reufer/gigafoc/hardware/P1B/gigafoc.pdf

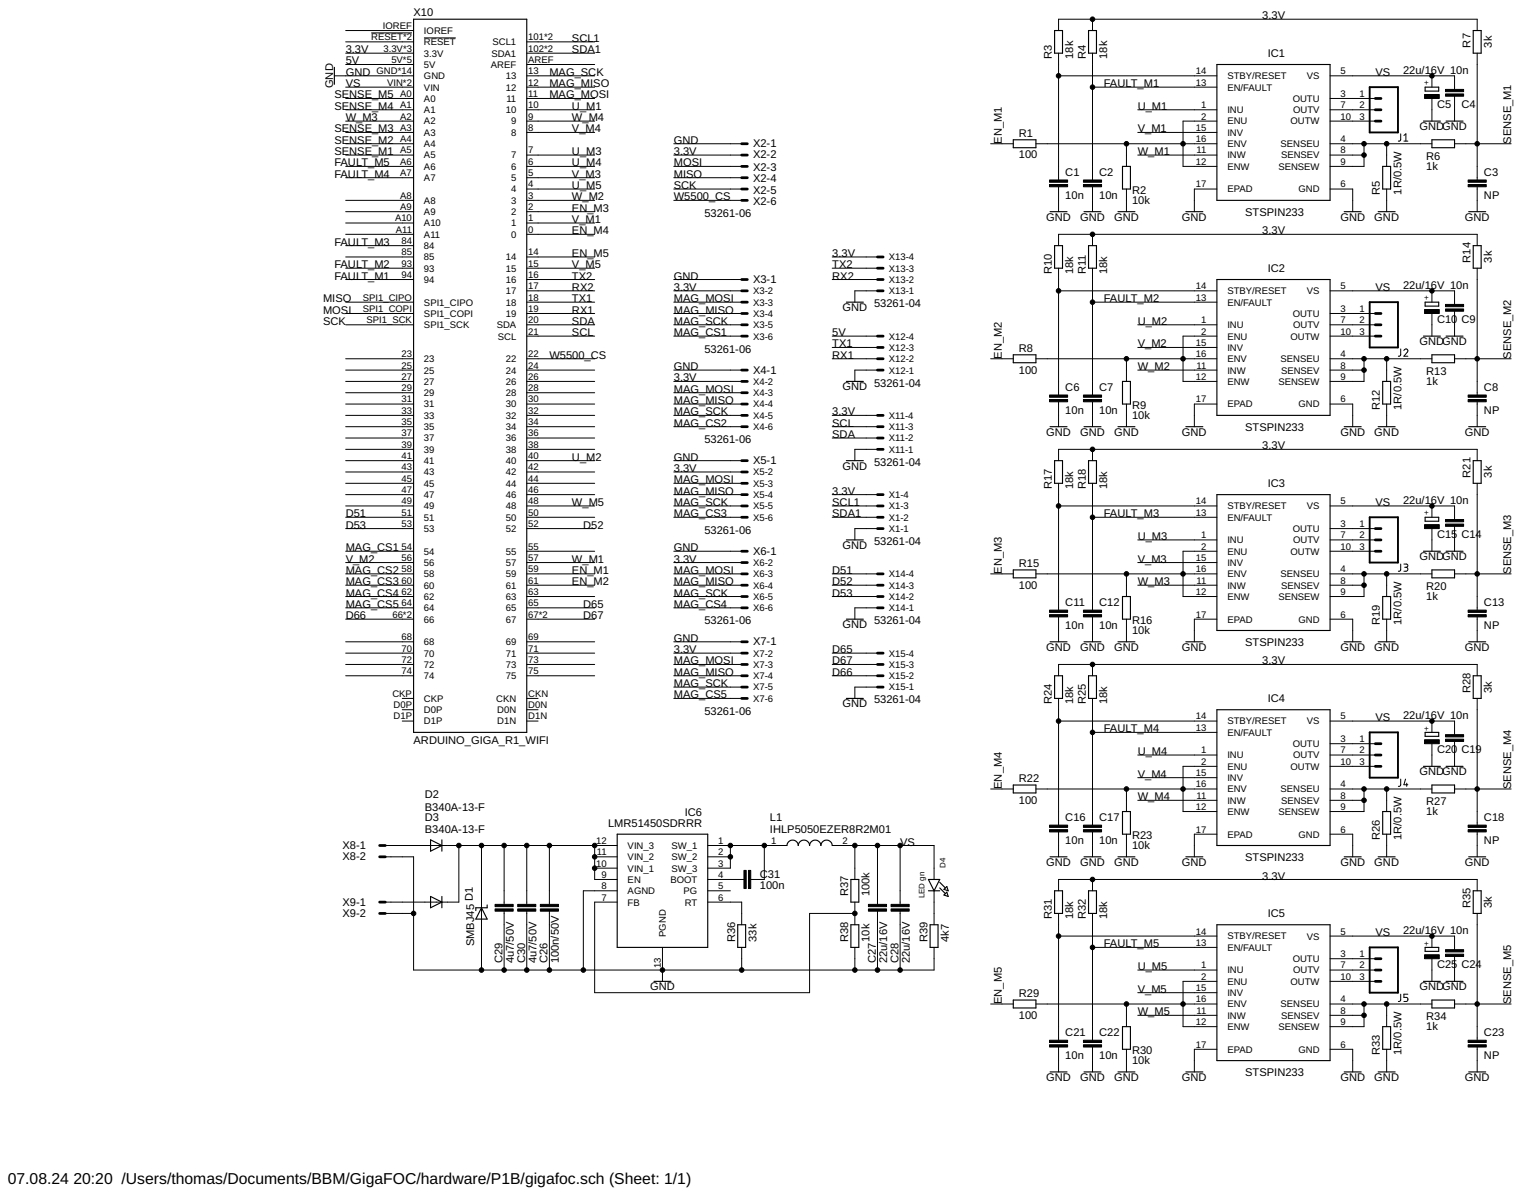
[picture p1: page 1]

18k 10n GND GND GND GND

07.08.24 20:20 /Users/thomas/Documents/BBM/GigaFOC/hardware/P1B/gigafoc.sch (Sheet: 1/1)
