reufer/gigafoc/hardware/P1A/gigafoc.pdf

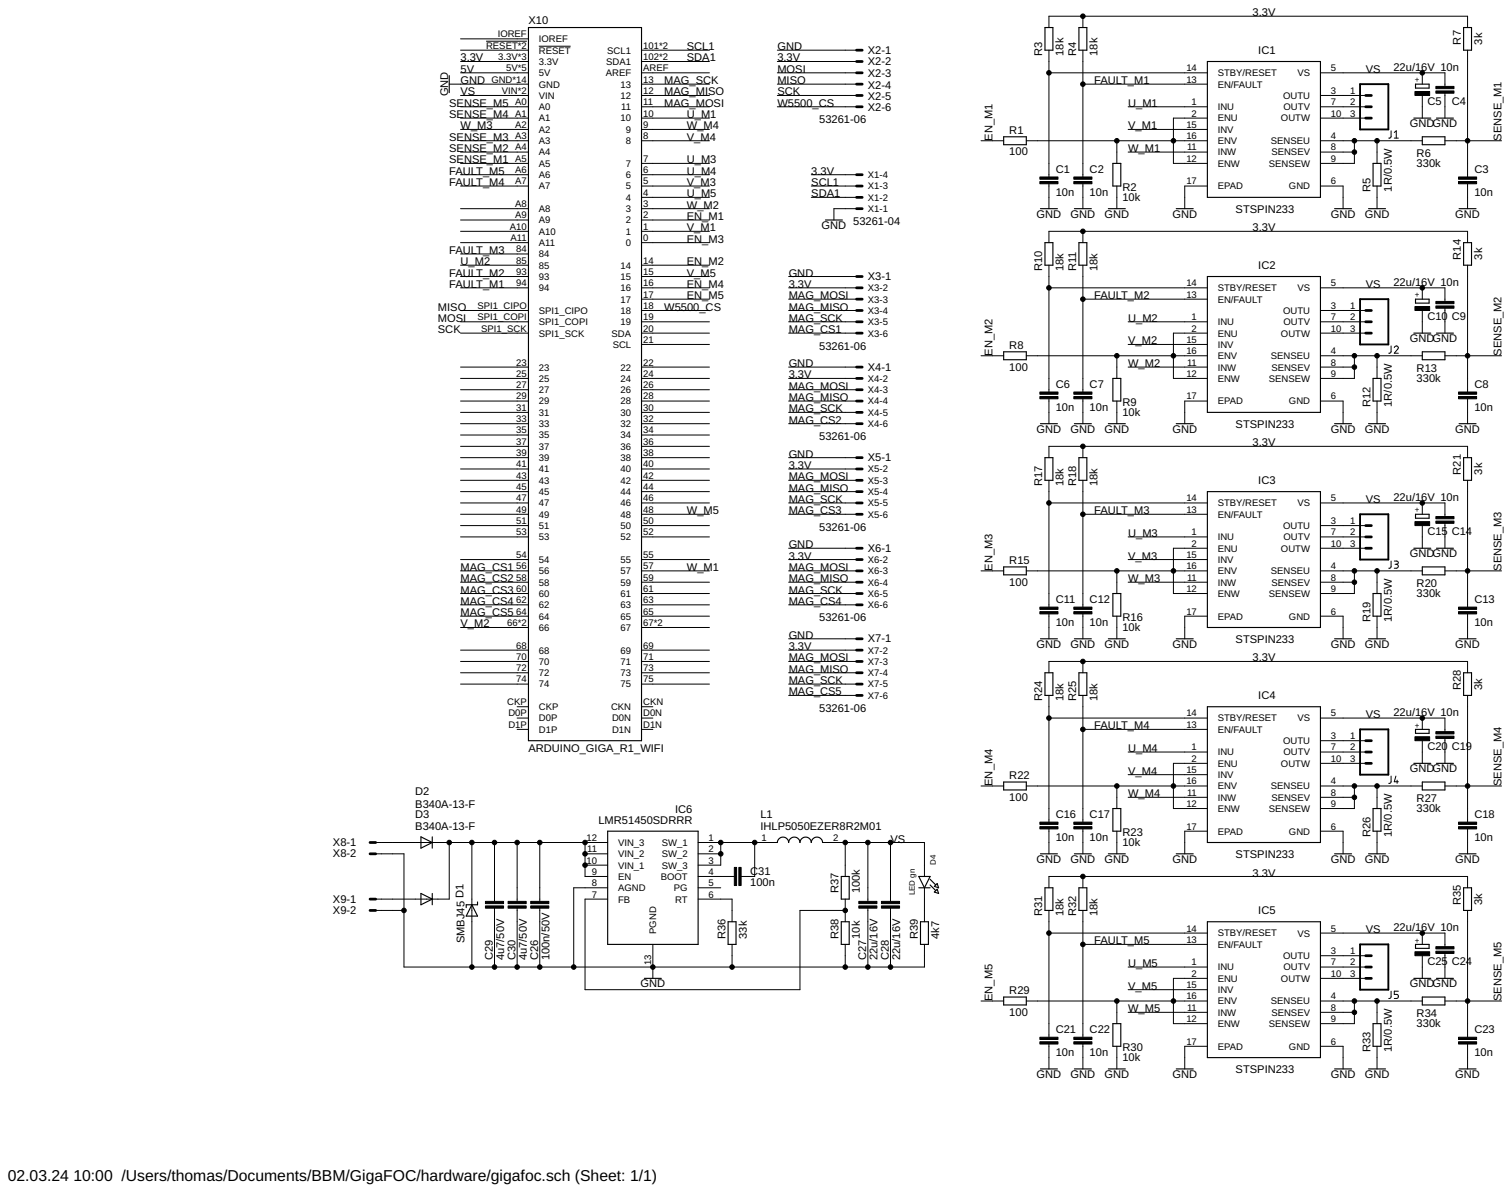
[picture p2: page 1]

18k 10n GND GND GND GND

02.03.24 10:00 /Users/thomas/Documents/BBM/GigaFOC/hardware/gigafoc.sch (Sheet: 1/1)
