reufer/gigafoc/hardware/P1B/gigafoc_bottom.pdf

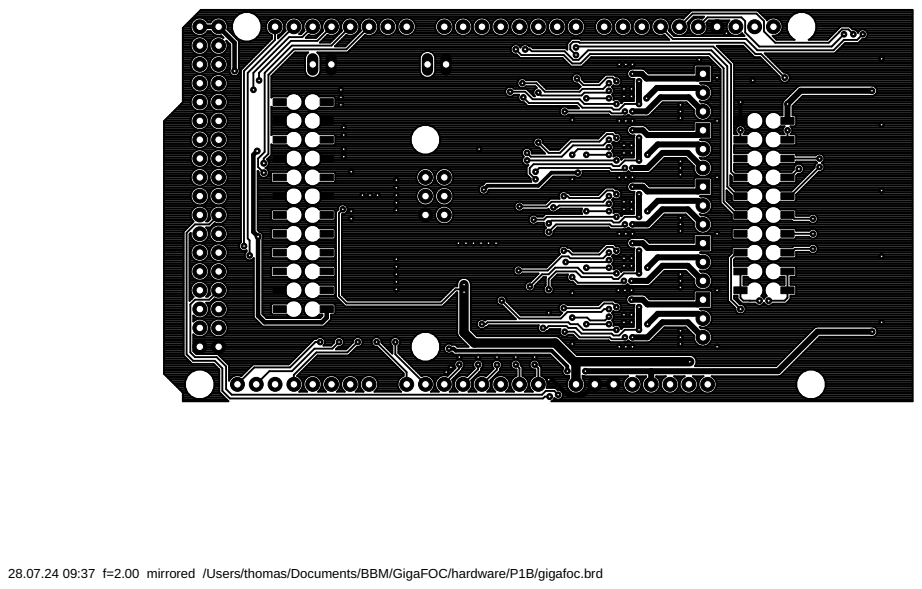
[picture p3: page 1]

28.07.24 09:37 f=2.00 mirrored /Users/thomas/Documents/BBM/GigaFOC/hardware/P1B/gigafoc.brd
