reufer/gigafoc/hardware/P1B/gigafoc_top.pdf

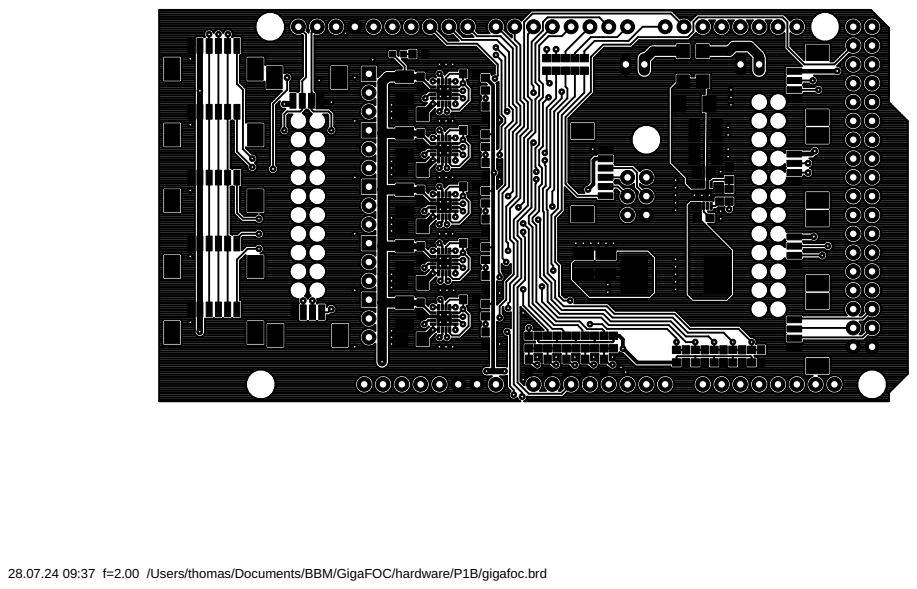
[picture p4: page 1]

28.07.24 09:37 f=2.00 /Users/thomas/Documents/BBM/GigaFOC/hardware/P1B/gigafoc.brd
