reufer/gigafoc/hardware/P1B/gigafoc_top_names.pdf

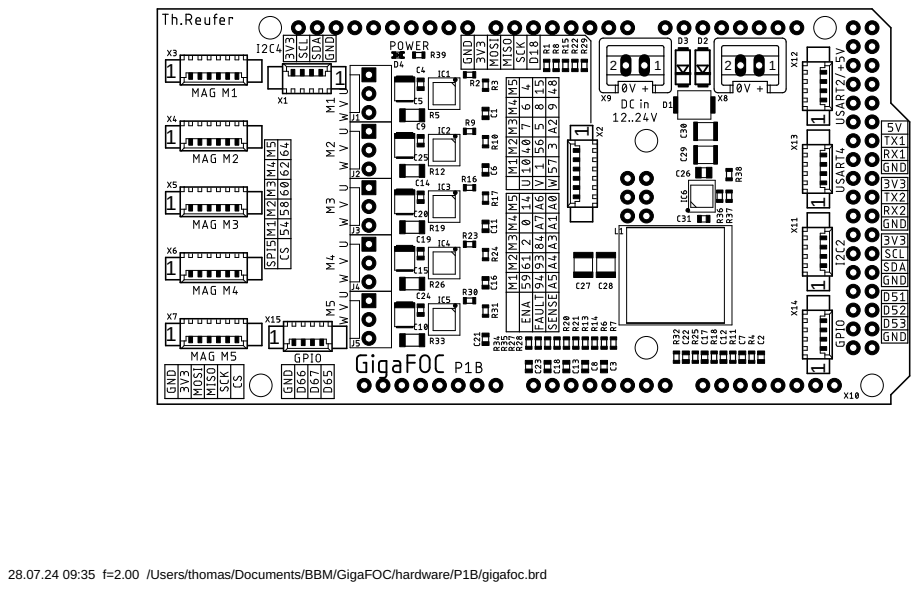
[picture p5: page 1]

28.07.24 09:35 f=2.00 /Users/thomas/Documents/BBM/GigaFOC/hardware/P1B/gigafoc.brd
