reufer/gigafoc/hardware/P1B/gigafoc_top_values.pdf

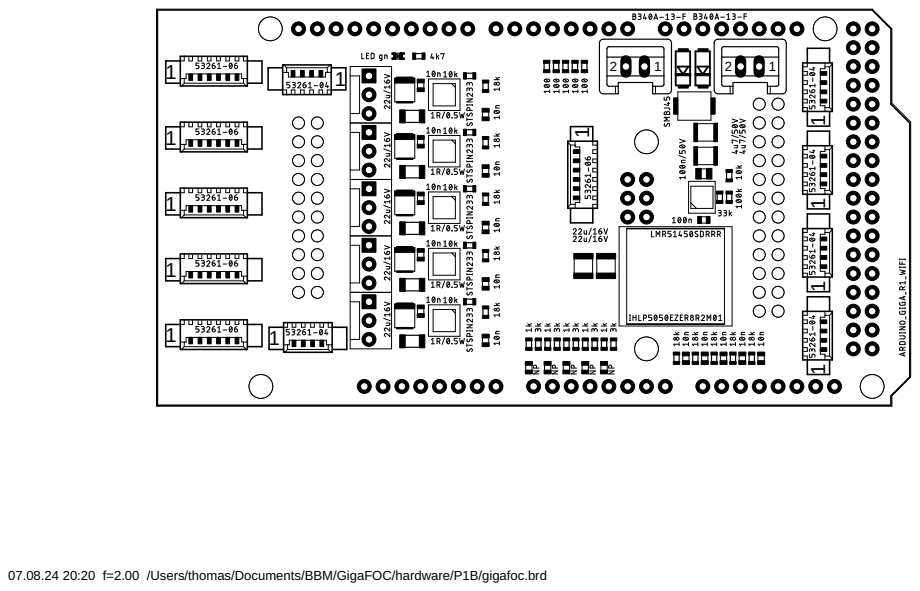
[picture p6: page 1]

07.08.24 20:20 f=2.00 /Users/thomas/Documents/BBM/GigaFOC/hardware/P1B/gigafoc.brd
