reufer/gigafoc/hardware/P1A/gigafoc_top_names.pdf

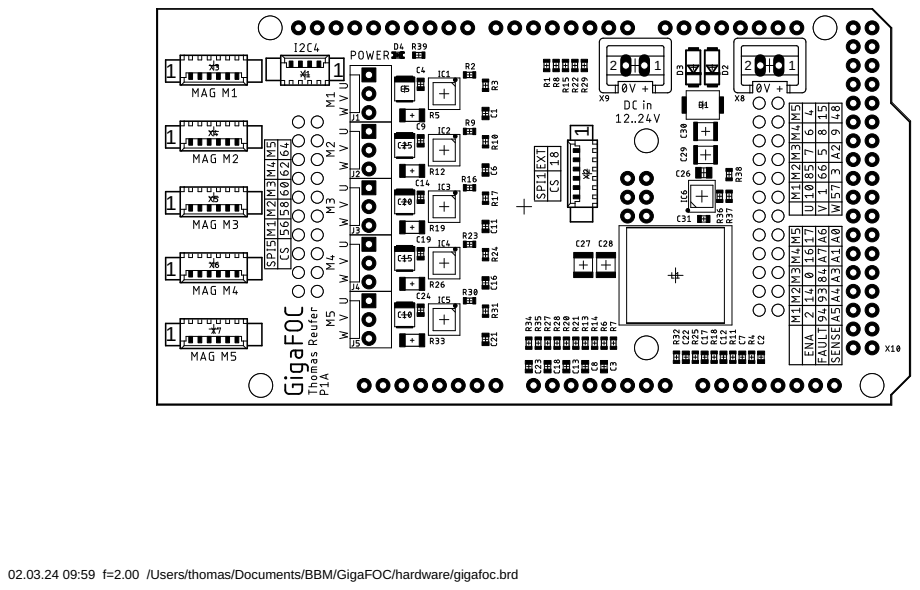
[picture p7: page 1]

02.03.24 09:59 f=2.00 /Users/thomas/Documents/BBM/GigaFOC/hardware/gigafoc.brd
