reufer/gigafoc/hardware/P1A/gigafoc_bottom.pdf

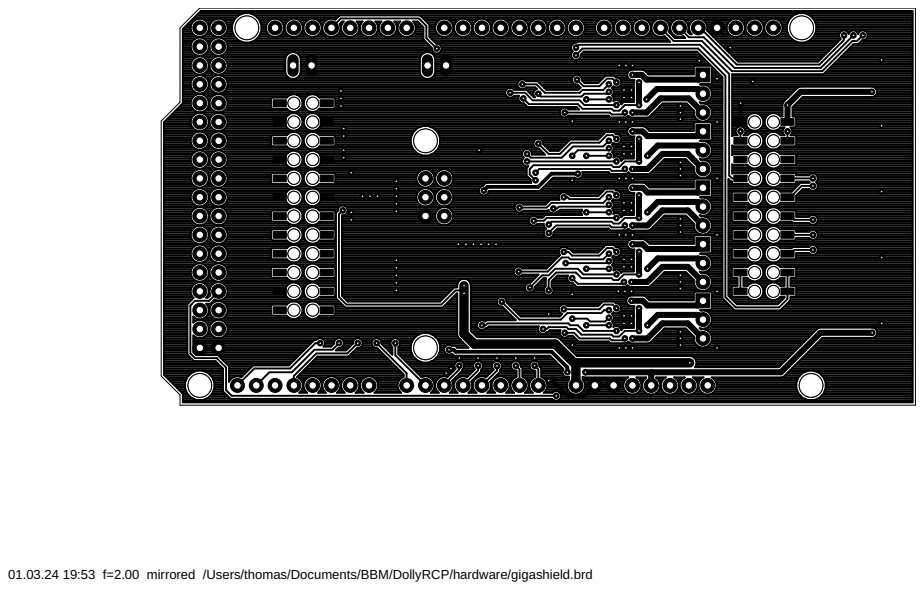
[picture p8: page 1]

01.03.24 19:53 f=2.00 mirrored /Users/thomas/Documents/BBM/DollyRCP/hardware/gigashield.brd
