reufer/gigafoc/hardware/P1A/gigafoc_top.pdf

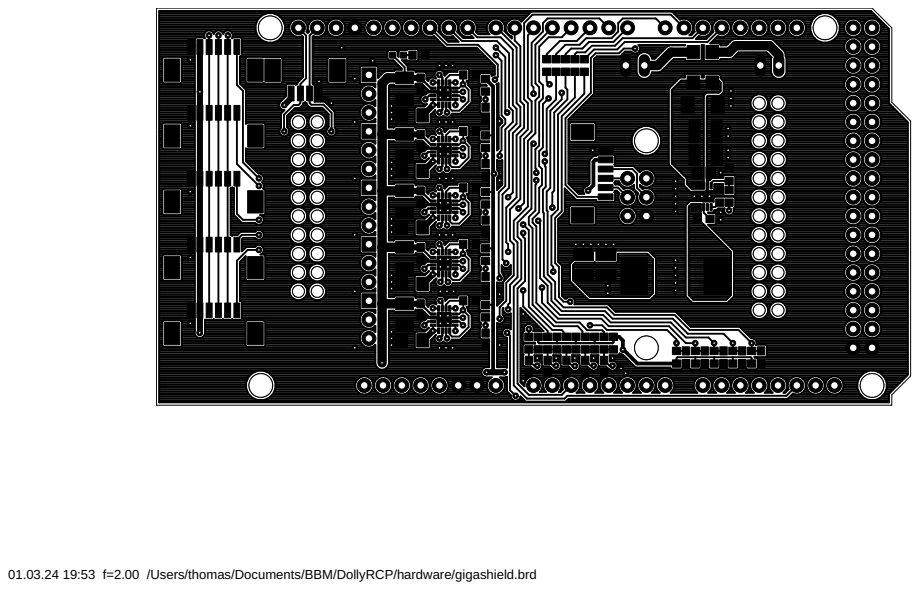
[picture p9: page 1]

01.03.24 19:53 f=2.00 /Users/thomas/Documents/BBM/DollyRCP/hardware/gigashield.brd
