reufer/gigafoc/hardware/P1A/gigafoc_top_values.pdf

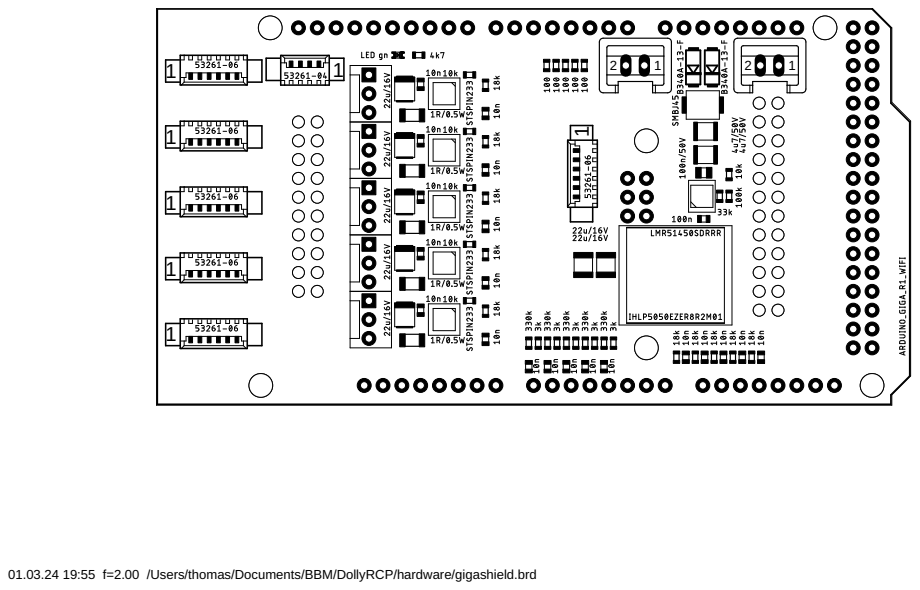
[picture p10: page 1]

01.03.24 19:55 f=2.00 /Users/thomas/Documents/BBM/DollyRCP/hardware/gigashield.brd
