reufer/gigafoc/hardware/P1B/gigafoc.brd

## EAGLE design hardware/P1B/gigafoc.brd (2024-08-08)

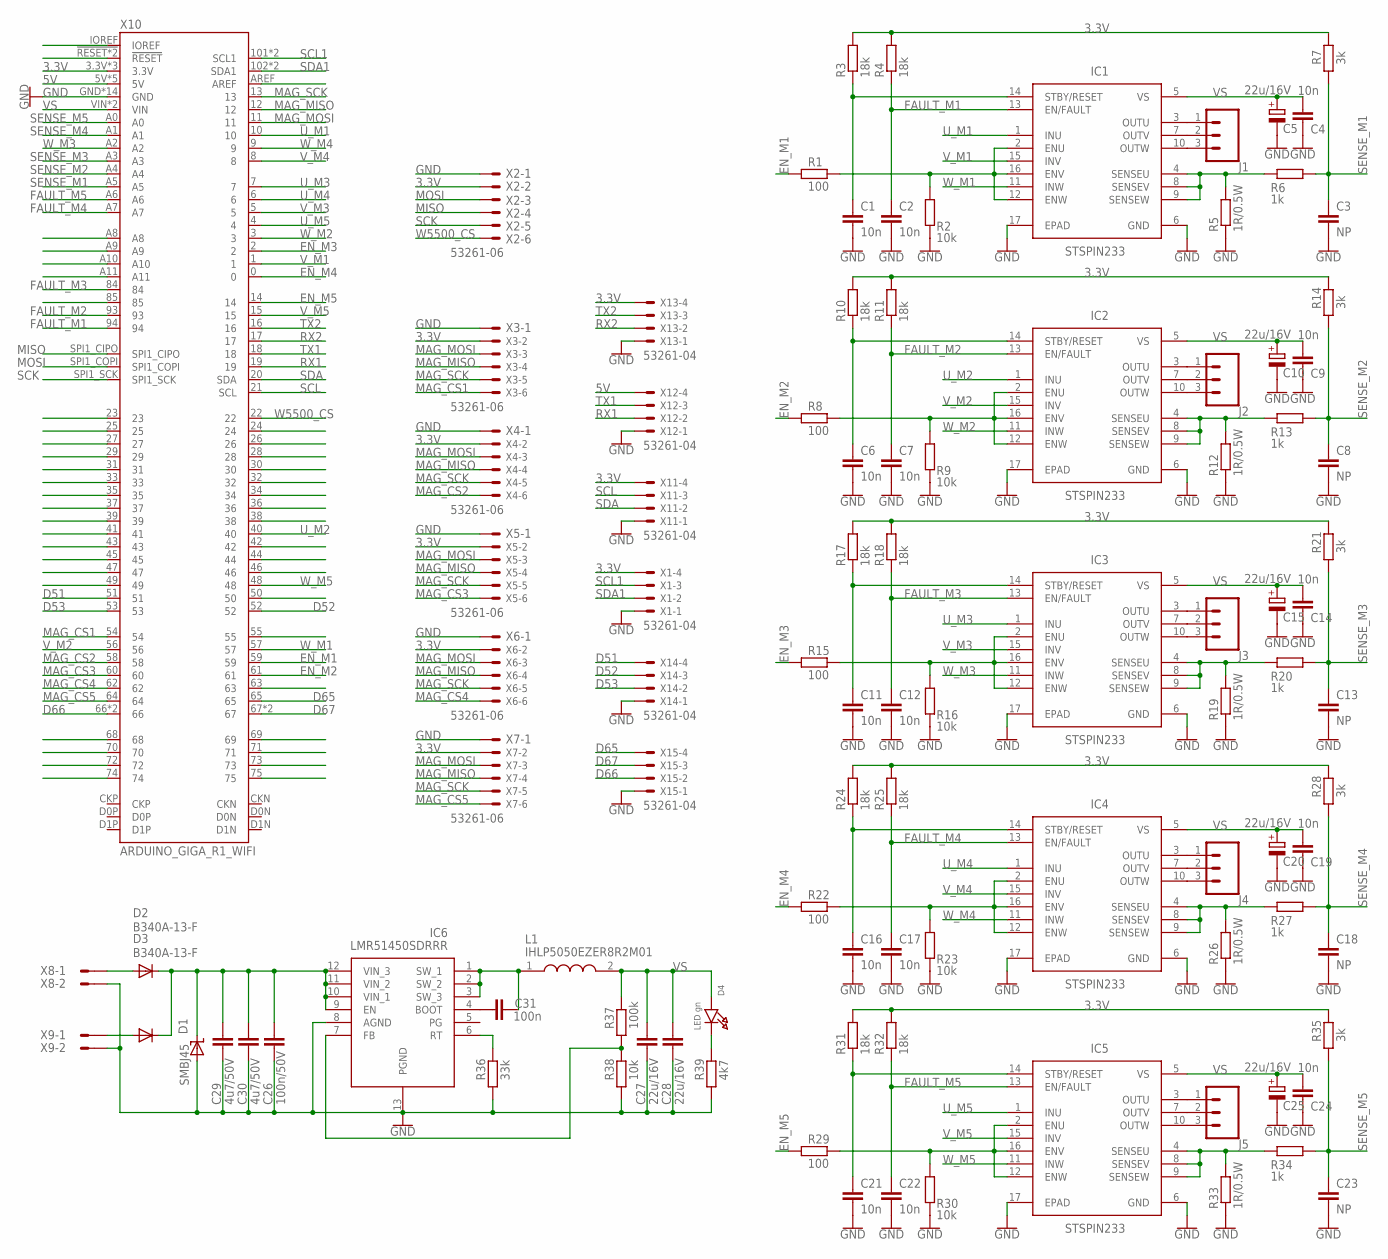
[picture p11: schematic gigafoc.sch]

Parts:
C1, C2, C4, C6, C7, C9, C11, C12, C14, C16, C17, C19, C21, C22, C24: 10n; C0603
C3, C8, C13, C18, C23: NP; C0603
C5, C10, C15, C20, C25: 22u/16V; SMC_B
C26: 100n/50V; C0805
C27, C28: 22u/16V; C1210
C29, C30: 4u7/50V; C1210K
C31: 100n; C0603
D1: SMBJ45; SMBJ
D2, D3: B340A-13-F; DO214AC
D4: LED gn; CHIPLED_0603_NOOUTLINE
IC1, IC2, IC3, IC4, IC5: STSPIN233; QFN50P300X300X100-17N
IC6: LMR51450SDRRR; SON50P300X300X80-13N
J1, J2, J3, J4, J5: CONN_03POLAR; MOLEX-1X3
L1: IHLP5050EZER8R2M01; INDPM132129X500N
R1, R8, R15, R22, R29: 100; R0603
R2, R9, R16, R23, R30, R38: 10k; R0603
R3, R4, R10, R11, R17, R18, R24, R25, R31, R32: 18k; R0603
R5, R12, R19, R26, R33: 1R/0.5W; R1206
R6, R13, R20, R27, R34: 1k; R0603
R7, R14, R21, R28, R35: 3k; R0603
R36: 33k; R0603
R37: 100k; R0603
R39: 4k7; R0603
X1, X11, X12, X13, X14, X15: 53261-04
X2, X3, X4, X5, X6, X7: 53261-06
X8, X9: S02P
X10: ARDUINO_GIGA_R1_WIFI; ARDUINO_GIGA_NO_SILK

Connections:
3.3V: R3.2, R4.2, R7.2, R10.2, R11.2, R14.2, R17.2, R18.2, R21.2, R24.2, R25.2, R28.2, R31.2, R32.2, R35.2, X1.4, X2.2, X3.2, X4.2, X5.2, X6.2, X7.2, X10.3.3V, X10.3.3V@1 (3.3V), X10.3.3V@2 (3.3V), X11.4, X13.4
5V: X10.5V, X10.5V@1 (5V), X10.5V@2 (5V), X10.5V@3 (5V), X10.5V@4 (5V), X12.4
24V: D2.A, X8.1
D51: X10.51, X14.4
D52: X10.52, X14.3
D53: X10.53, X14.2
D65: X10.65, X15.4
D66: X10.66, X10.66@1 (66), X15.2
D67: X10.67, X10.67@1 (67), X15.3
EN_M1: R1.1, X10.59
EN_M2: R8.1, X10.61
EN_M3: R15.1, X10.2
EN_M4: R22.1, X10.0
EN_M5: R29.1, X10.14
FAULT_M1: C2.2, IC1.13 (EN/FAULT), R4.1, X10.94
FAULT_M2: C7.2, IC2.13 (EN/FAULT), R11.1, X10.93
FAULT_M3: C12.2, IC3.13 (EN/FAULT), R18.1, X10.84
FAULT_M4: C17.2, IC4.13 (EN/FAULT), R25.1, X10.A7
FAULT_M5: C22.2, IC5.13 (EN/FAULT), R32.1, X10.A6
GND: C1.1, C2.1, C3.1, C4.1, C5.-, C6.1, C7.1, C8.1, C9.1, C10.-, C11.1, C12.1, C13.1, C14.1, C15.-, C16.1, C17.1, C18.1, C19.1, C20.-, C21.1, C22.1, C23.1, C24.1, C25.-, C26.2, C27.2, C28.2, C29.2, C30.2, D1.A, IC1.6 (GND), IC1.17 (EPAD), IC2.6 (GND), IC2.17 (EPAD), IC3.6 (GND), IC3.17 (EPAD), IC4.6 (GND), IC4.17 (EPAD), IC5.6 (GND), IC5.17 (EPAD), IC6.8 (AGND), IC6.13 (PGND), R2.1, R5.1, R9.1, R12.1, R16.1, R19.1, R23.1, R26.1, R30.1, R33.1, R36.1, R38.1, R39.1, X1.1, X2.1, X3.1, X4.1, X5.1, X6.1, X7.1, X8.2, X9.2, X10.GND, X10.GND@1 (GND), X10.GND@2 (GND), X10.GND@3 (GND), X10.GND@4 (GND), X10.GND@5 (GND), X10.GND@6 (GND), X10.GND@7 (GND), X10.GND@8 (GND), X10.GND@9 (GND), X10.GND@10 (GND), X10.GND@11 (GND), X10.GND@12 (GND), X10.GND@13 (GND), X11.1, X12.1, X13.1, X14.1, X15.1
MAG_CS1: X3.6, X10.54
MAG_CS2: X4.6, X10.58
MAG_CS3: X5.6, X10.60
MAG_CS4: X6.6, X10.62
MAG_CS5: X7.6, X10.64
MAG_MISO: X3.4, X4.4, X5.4, X6.4, X7.4, X10.12
MAG_MOSI: X3.3, X4.3, X5.3, X6.3, X7.3, X10.11
MAG_SCK: X3.5, X4.5, X5.5, X6.5, X7.5, X10.13
MISO: X2.4, X10.SPI1_CIPO
MOSI: X2.3, X10.SPI1_COPI
unnamed: IC1.2 (ENU), IC1.12 (ENW), IC1.16 (ENV), R1.2, R2.2
unnamed: C1.2, IC1.14 (STBY/RESET), R3.1
unnamed: IC1.4 (SENSEU), IC1.8 (SENSEV), IC1.9 (SENSEW), R5.2, R6.1
unnamed: C31.1, IC6.4 (BOOT)
unnamed: C31.2, IC6.1 (SW_1), IC6.2 (SW_2), IC6.3 (SW_3), L1.1
unnamed: IC1.3 (OUTU), J1.1
unnamed: IC1.7 (OUTV), J1.2
unnamed: IC1.10 (OUTW), J1.3
unnamed: D4.C, R39.2
unnamed: D3.A, X9.1
unnamed: IC6.7 (FB), R37.1, R38.2
unnamed: IC6.6 (RT), R36.2
unnamed: IC2.2 (ENU), IC2.12 (ENW), IC2.16 (ENV), R8.2, R9.2
unnamed: C6.2, IC2.14 (STBY/RESET), R10.1
unnamed: IC2.4 (SENSEU), IC2.8 (SENSEV), IC2.9 (SENSEW), R12.2, R13.1
unnamed: IC2.3 (OUTU), J2.1
unnamed: IC2.7 (OUTV), J2.2
unnamed: IC2.10 (OUTW), J2.3
unnamed: IC3.2 (ENU), IC3.12 (ENW), IC3.16 (ENV), R15.2, R16.2
unnamed: C11.2, IC3.14 (STBY/RESET), R17.1
unnamed: IC3.4 (SENSEU), IC3.8 (SENSEV), IC3.9 (SENSEW), R19.2, R20.1
unnamed: X10.!RESET, X10.RESET (!RESET)
unnamed: IC3.3 (OUTU), J3.1
unnamed: IC3.7 (OUTV), J3.2
unnamed: IC3.10 (OUTW), J3.3
unnamed: IC4.2 (ENU), IC4.12 (ENW), IC4.16 (ENV), R22.2, R23.2
unnamed: C16.2, IC4.14 (STBY/RESET), R24.1
unnamed: IC4.4 (SENSEU), IC4.8 (SENSEV), IC4.9 (SENSEW), R26.2, R27.1
unnamed: IC4.3 (OUTU), J4.1
unnamed: IC4.7 (OUTV), J4.2
unnamed: IC4.10 (OUTW), J4.3
unnamed: IC5.2 (ENU), IC5.12 (ENW), IC5.16 (ENV), R29.2, R30.2
unnamed: C21.2, IC5.14 (STBY/RESET), R31.1
unnamed: IC5.4 (SENSEU), IC5.8 (SENSEV), IC5.9 (SENSEW), R33.2, R34.1
unnamed: IC5.3 (OUTU), J5.1
unnamed: IC5.7 (OUTV), J5.2
unnamed: IC5.10 (OUTW), J5.3
RX1: X10.19, X12.2
RX2: X10.17, X13.2
SCK: X2.5, X10.SPI1_SCK
SCL: X10.21 (SCL), X11.3
SCL1: X1.3, X10.101 (SCL1), X10.101@1 (SCL1)
SDA: X10.20 (SDA), X11.2
SDA1: X1.2, X10.102 (SDA1), X10.102@1 (SDA1)
SENSE_M1: C3.2, R6.2, R7.1, X10.A5
SENSE_M2: C8.2, R13.2, R14.1, X10.A4
SENSE_M3: C13.2, R20.2, R21.1, X10.A3
SENSE_M4: C18.2, R27.2, R28.1, X10.A1
SENSE_M5: C23.2, R34.2, R35.1, X10.A0
TX1: X10.18, X12.3
TX2: X10.16, X13.3
U_M1: IC1.1 (INU), X10.10
U_M2: IC2.1 (INU), X10.40
U_M3: IC3.1 (INU), X10.7
U_M4: IC4.1 (INU), X10.6
U_M5: IC5.1 (INU), X10.4
VIN: C26.1, C29.1, C30.1, D1.C, D2.C, D3.C, IC6.9 (EN), IC6.10 (VIN_1), IC6.11 (VIN_2), IC6.12 (VIN_3)
VS: C4.2, C5.+, C9.2, C10.+, C14.2, C15.+, C19.2, C20.+, C24.2, C25.+, C27.1, C28.1, D4.A, IC1.5 (VS), IC2.5 (VS), IC3.5 (VS), IC4.5 (VS), IC5.5 (VS), L1.2, R37.2, X10.VIN, X10.VIN@1 (VIN)
V_M1: IC1.15 (INV), X10.1
V_M2: IC2.15 (INV), X10.56
V_M3: IC3.15 (INV), X10.5
V_M4: IC4.15 (INV), X10.8
V_M5: IC5.15 (INV), X10.15
W5500_CS: X2.6, X10.22
W_M1: IC1.11 (INW), X10.57
W_M2: IC2.11 (INW), X10.3
W_M3: IC3.11 (INW), X10.A2
W_M4: IC4.11 (INW), X10.9
W_M5: IC5.11 (INW), X10.48

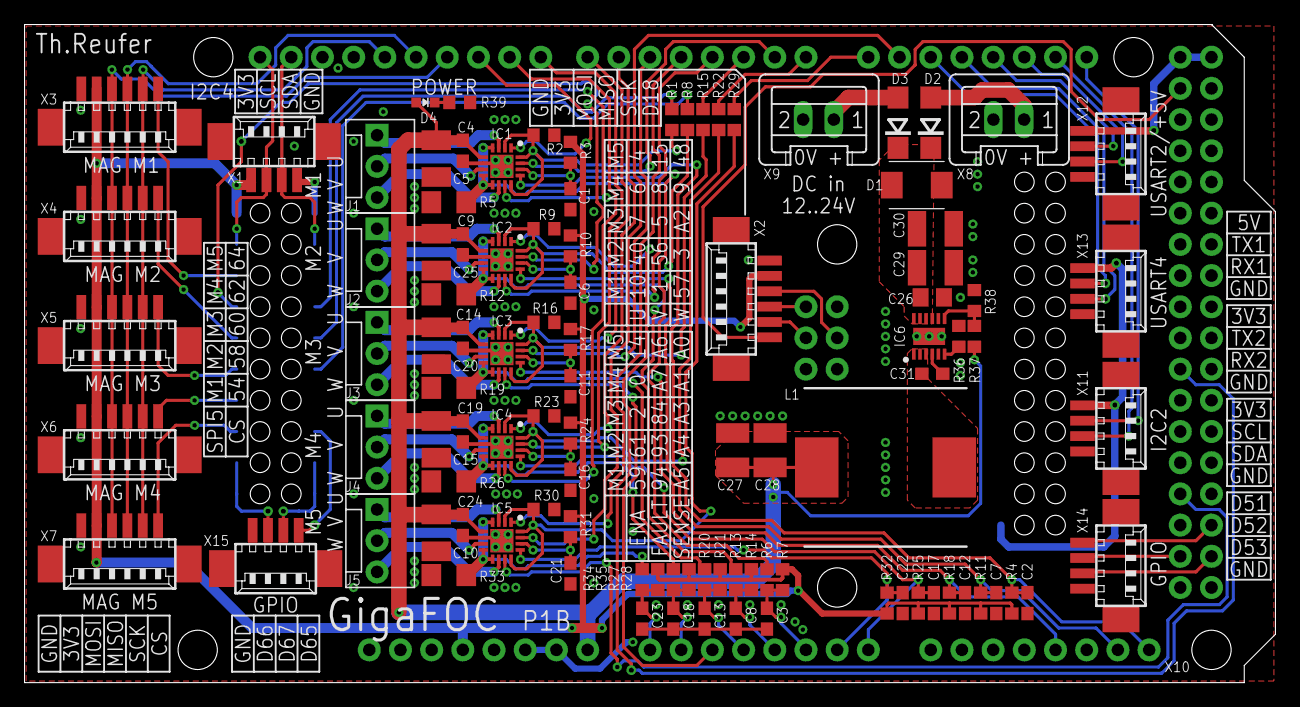
[picture p12: board gigafoc.brd from above]

Board: 2 copper layers, 101.9 x 53.6 mm, 101 parts (0 on the bottom side), 99 nets.
