reufer/gigafoc/hardware/sensor/sensor.brd

## EAGLE design hardware/sensor/sensor.brd (2024-08-08)

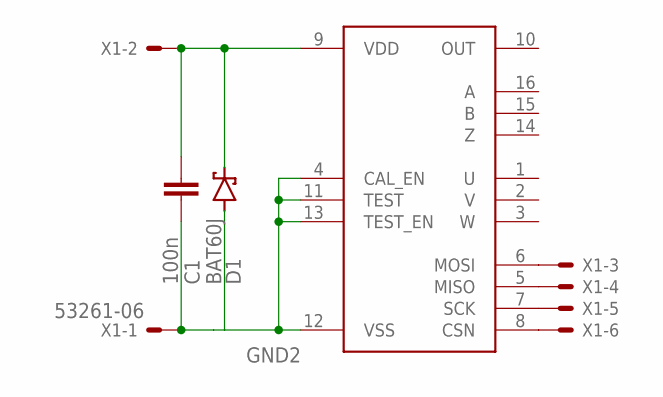
[picture p13: schematic sensor.sch]

Parts:
C1: 100n; C0603
D1: BAT60J; SOD323_ST
IC1: MT6835; TSSOP-16
X1: 53261-06

Connections:
GND2: C1.2, D1.A, IC1.4 (CAL_EN), IC1.11 (TEST), IC1.12 (VSS), IC1.13 (TEST_EN), X1.1
unnamed: IC1.5 (MISO), X1.4
unnamed: IC1.7 (SCK), X1.5
unnamed: IC1.8 (CSN), X1.6
unnamed: IC1.6 (MOSI), X1.3
unnamed: C1.1, D1.C, IC1.9 (VDD), X1.2

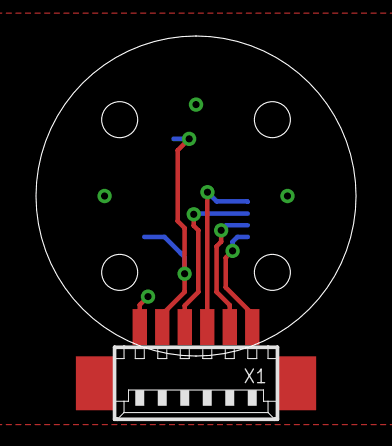
[picture p14: board sensor.brd from above]

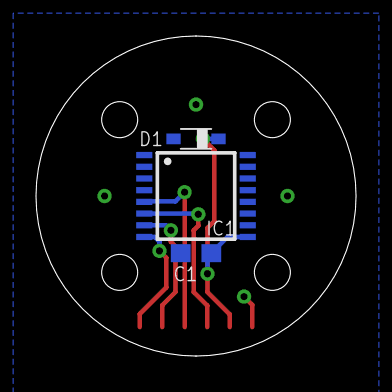
[picture p15: board sensor.brd from below]

Board: 2 copper layers, 17.8 x 17.8 mm, 4 parts (3 on the bottom side), 6 nets.
